HIIACODER/Sol-Mk.-I/BOM.csv

Designator | Footprint | Quantity | Value | LCSC Part #
C1, C10, C14 | C_0402 | 3 | 1uF
C11, C12, C13, C16, C17, C18, C2, C4, C5, C7, C8, C9 | C_0402 | 12 | 10uF
C15, C19, C20, C22, C24, C28, C29, C30, C31, C32, C33, C34, C35, C36, C40, C41, C42 | C_0402 | 17 | 100nF
C21 | C_0402 | 1 | 10nF
C23 | C_0402 | 1 | 2.2uF
C25, C26 | C_0603 | 2 | 4.7uF
C3 | C_0402 | 1 | 47nF
C37, C6 | C_0402 | 2 | 4.7uF
C38, C39 | C_0402 | 2 | 15pF
CARD1 | TF-SMD_TF-01A | 1 | TF-01A | C91145
CN1 | CONN-TH_XT30UPB-M | 1 | XT30UPB-M | C428721
D1 | SOT-23-6_L2.9-W1.6-P0.95-LS2.8-BL | 1 | USBLC6-2SC6 | C7519
D2 | C19273150_LED0603-RD | 1 | LED | C19273150
D4 | C22371297_LED0603-RD_GREEN | 1 | Signal LED1 | C22371297
H5 | C2937625_HDR-TH_3P-P2_54-V-M_PZ254V-11-03P | 1 | SERVOH1 | C2937625
H6 | C2937625_HDR-TH_3P-P2_54-V-M_PZ254V-11-03P | 1 | SERVOH2 | C2937625
H7 | C2937625_HDR-TH_3P-P2_54-V-M_PZ254V-11-03P | 1 | SERVON1 | C2937625
H8 | C2937625_HDR-TH_3P-P2_54-V-M_PZ254V-11-03P | 1 | SERVON2 | C2937625
H9 | C2937625_HDR-TH_3P-P2_54-V-M_PZ254V-11-03P | 1 | DEBUG | C2937625
L1 | C42455356_IND-SMD_APH252012C3R3MP01 | 1 | 1uH | C42455356
L2 | C42411119_IND-SMD_L2_0-W1_6_AOTA-B201610S3R3-101-T | 1 | 3.3uH | C42411119
R1, R2 | R0402 | 2 | 5.1K | C25104
R10, R11, R18, R19, R20, R21, R22, R23, R24, R6, R8, R9, TH1 | R0402 | 13 | 10K | C25104
R12 | R0402 | 1 | 75K | C25104
R13 | R0402 | 1 | 24K | C25104
R14, R15 | R0402 | 2 | 100K | C25104
R16 | R0402 | 1 | 105K | C25104
R17 | R0402 | 1 | 20K | C25104
R25, R26, R7 | R0402 | 3 | 1K | C25104
R27 | R0402 | 1 | 33 | C25104
R28, R29 | R0402 | 2 | 27 | C25104
R3 | R0402 | 1 | 5.23K | C25104
R30 | R0402 | 1 | 130 | C25104
R4 | R0402 | 1 | 30.1K | C25104
R5 | R0402 | 1 | 383 | C25104
SW1 | C720477_SW-SMD_L3_9-W3_0-P4_45 | 1 | SW_Push | C720477
U1 | VFQFPN-24_L4.0-W4.0-P0.50-BL-EP2.8 | 1 | BQ25883RGER | C544362
U2 | C41378174_QFN-60_L7_0-W7_0-P0_40-TL-EP3_4 | 1 | RP2354A | C41378174
U3, U4 | C473914_USIP-8_L3_0-W2_8-P0_65-TL-EP | 2 | TPS82130SILR | C473914
U5 | LGA-10_L2.0-W2.0-P0.50-TL_BMP581 | 1 | BMP581 | C5362283
U6 | C1850418_LGA-14_L3_0-W2_5-P0_50-TL | 1 | ICM-42688-P | C1850418
U7 | C20625731_CRYSTAL-SMD_4P-L3_2-W2_5-BL | 1 | Crystal | C20625731
USB1 | USB-C-SMD_TYPE-C-16PIN-2MD-073 | 1 | TYPE-C 16PIN 2MD | C2765186
