HIIACODER/Sol-Mk.-I/Hardware/PCB/.stl

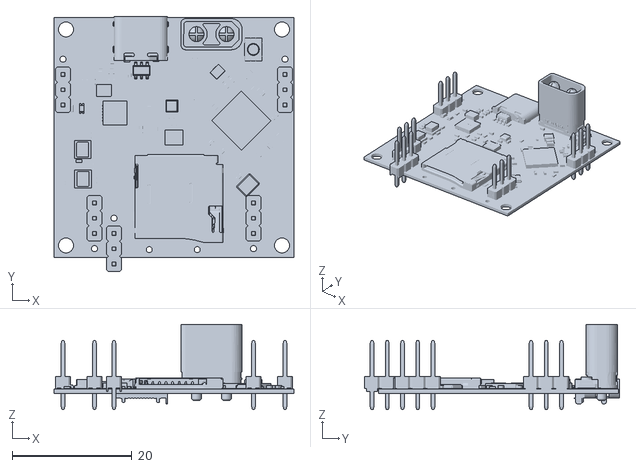
[picture p1: CAD file, 2026-11-11]
Hardware/PCB/.stl
40.0 x 42.5 x 14.2
