HIIACODER/Sol-Mk.-I/Hardware/PCB/PCB.kicad_pcb

## KiCad design Hardware/PCB/PCB.kicad_pcb (2026-11-12)

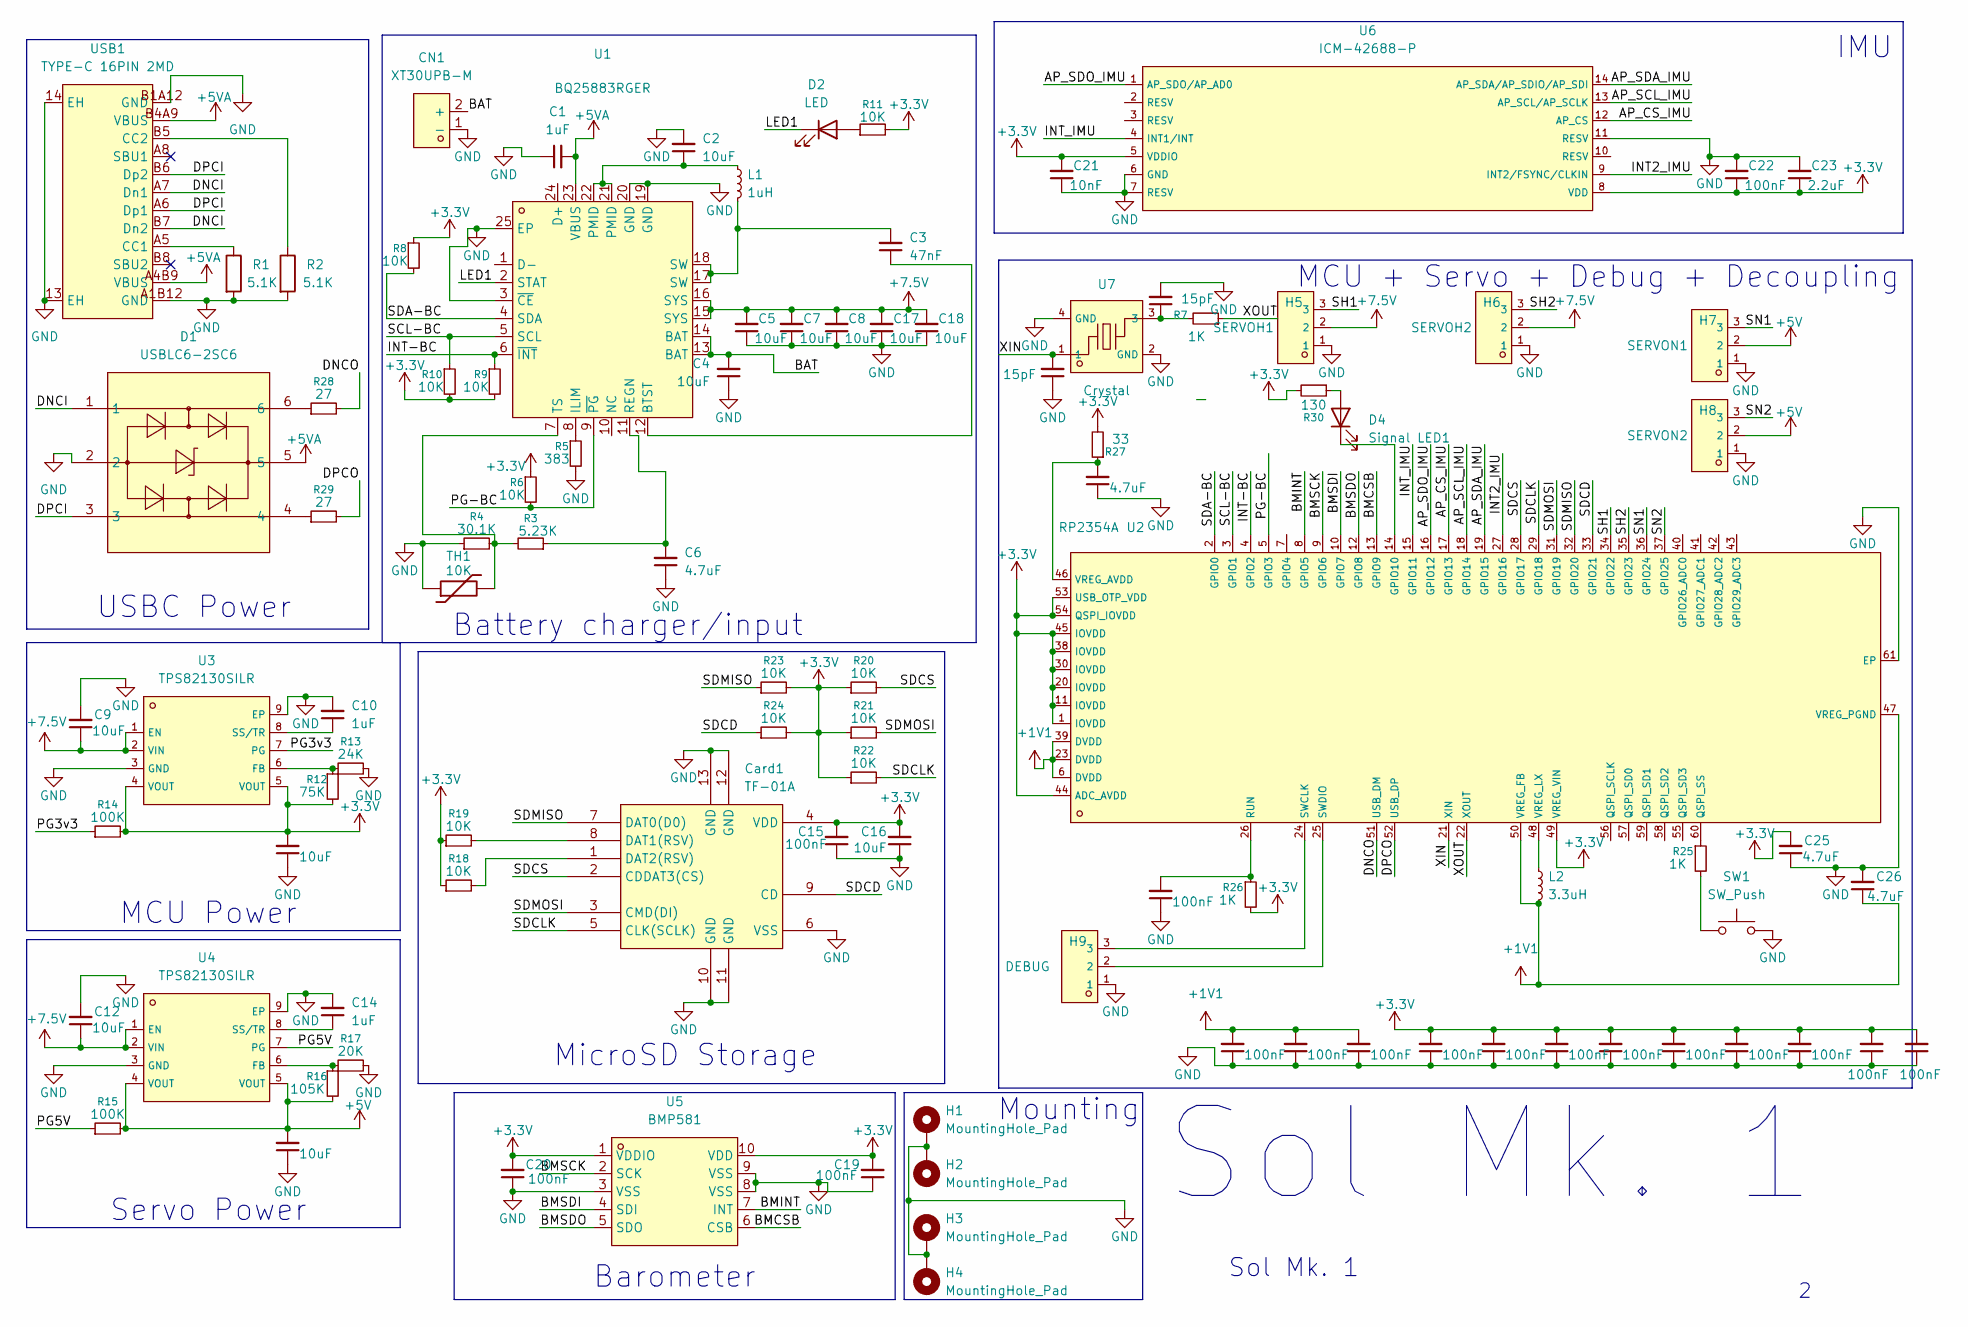
[picture p2: schematic PCB.kicad_sch]

Parts:
C1, C10, C14: 1uF; C_0402
C2, C4, C5, C7, C8, C9, C11, C12, C13, C16, C17, C18: 10uF; C_0402
C3: 47nF; C_0402
C6, C37: 4.7uF; C_0402
C15, C19, C20, C22, C24, C28, C29, C30, C31, C32, C33, C34, C35, C36, C40, C41, C42: 100nF; C_0402
C21: 10nF; C_0402
C23: 2.2uF; C_0402
C25, C26: 4.7uF; C_0603
C38, C39: 15pF; C_0402
CN1: XT30UPB-M; CONN-TH_XT30UPB-M; MPN XT30UPB-M; LCSC Part C428721
Card1: TF-01A; TF-SMD_TF-01A; MPN TF-01A; LCSC Part C91145
D1: USBLC6-2SC6; SOT-23-6_L2.9-W1.6-P0.95-LS2.8-BL; MPN USBLC6-2SC6; LCSC Part C7519
D2: LED; C19273150_LED0603-RD
D4: Signal LED1; C22371297_LED0603-RD_GREEN
H1, H2, H3, H4: MountingHole_Pad; MountingHole_2.5mm
H5: SERVOH1; C2937625_HDR-TH_3P-P2_54-V-M_PZ254V-11-03P; LCSC C2937625
H6: SERVOH2; C2937625_HDR-TH_3P-P2_54-V-M_PZ254V-11-03P; LCSC C2937625
H7: SERVON1; C2937625_HDR-TH_3P-P2_54-V-M_PZ254V-11-03P; LCSC C2937625
H8: SERVON2; C2937625_HDR-TH_3P-P2_54-V-M_PZ254V-11-03P; LCSC C2937625
H9: DEBUG; C2937625_HDR-TH_3P-P2_54-V-M_PZ254V-11-03P; LCSC C2937625
L1: 1uH; C42455356_IND-SMD_APH252012C3R3MP01
L2: 3.3uH; C42411119_IND-SMD_L2_0-W1_6_AOTA-B201610S3R3-101-T
R1, R2: 5.1K; R0402
R3: 5.23K; R0402
R4: 30.1K; R0402
R5: 383; R0402
R6, R8, R9, R10, R11, R18, R19, R20, R21, R22, R23, R24: 10K; R0402
R7, R25, R26: 1K; R0402
R12: 75K; R0402
R13: 24K; R0402
R14, R15: 100K; R0402
R16: 105K; R0402
R17: 20K; R0402
R27: 33; R0402
R28, R29: 27; R0402
R30: 130; R0402
SW1: SW_Push; C720477_SW-SMD_L3_9-W3_0-P4_45
TH1: 10K; R0402
U1: BQ25883RGER; VFQFPN-24_L4.0-W4.0-P0.50-BL-EP2.8; MPN BQ25883RGER; LCSC Part C544362
U2: RP2354A; C41378174_QFN-60_L7_0-W7_0-P0_40-TL-EP3_4; LCSC C41378174
U3, U4: TPS82130SILR; C473914_USIP-8_L3_0-W2_8-P0_65-TL-EP; LCSC C473914
U5: BMP581; LGA-10_L2.0-W2.0-P0.50-TL_BMP581; MPN BMP581; LCSC Part C5362283
U6: ICM-42688-P; C1850418_LGA-14_L3_0-W2_5-P0_50-TL; LCSC C1850418
U7: Crystal; C20625731_CRYSTAL-SMD_4P-L3_2-W2_5-BL; LCSC C20625731
USB1: TYPE-C 16PIN 2MD; USB-C-SMD_TYPE-C-16PIN-2MD-073; MPN TYPE-C 16PIN 2MD(073); LCSC Part C2765186

Connections:
+1V1: C26.1, C28.2, C29.2, C41.2, L2.2, U2.6 (DVDD), U2.23 (DVDD), U2.39 (DVDD), U2.50 (VREG_FB)
+3.3V: C11.2, C15.2, C16.2, C19.2, C20.2, C21.2, C22.1, C23.1, C25.2, C30.2, C31.2, C32.2, C33.2, C34.2, C35.2, C36.2, C40.2, C42.2, Card1.4 (VDD), R6.1, R8.1, R9.2, R10.2, R11.2, R12.2, R14.2, R18.1, R19.1, R20.1, R21.1, R22.1, R23.2, R24.2, R26.2, R27.2, R30.2, U2.1 (IOVDD), U2.11 (IOVDD), U2.20 (IOVDD), U2.30 (IOVDD), U2.38 (IOVDD), U2.44 (ADC_AVDD), U2.45 (IOVDD), U2.49 (VREG_VIN), U2.53 (USB_OTP_VDD), U2.54 (QSPI_IOVDD), U3.4 (VOUT), U3.5 (VOUT), U5.1 (VDDIO), U5.10 (VDD), U6.5 (VDDIO), U6.8 (VDD)
+5V: C13.2, H7.2, H8.2, R15.2, R16.2, U4.4 (VOUT), U4.5 (VOUT)
+5VA: C1.2, D1.5, U1.23 (VBUS), USB1.A4B9 (VBUS), USB1.B4A9 (VBUS)
+7.5V: C5.2, C7.2, C8.2, C9.1, C12.1, C17.2, C18.2, H5.2, H6.2, U1.15 (SYS), U1.16 (SYS), U3.1 (EN), U3.2 (VIN), U4.1 (EN), U4.2 (VIN)
/AP_CS_IMU: U2.17 (GPIO13), U6.12 (AP_CS)
/AP_SCL_IMU: U2.18 (GPIO14), U6.13 (AP_SCL/AP_SCLK)
/AP_SDA_IMU: U2.19 (GPIO15), U6.14 (AP_SDA/AP_SDIO/AP_SDI)
/AP_SDO_IMU: U2.16 (GPIO12), U6.1 (AP_SDO/AP_AD0)
/BAT: C4.2, CN1.2 (+), U1.13 (BAT), U1.14 (BAT)
/BMCSB: U2.13 (GPIO9), U5.6 (CSB)
/BMINT: U2.8 (GPIO5), U5.7 (INT)
/BMSCK: U2.9 (GPIO6), U5.2 (SCK)
/BMSDI: U2.10 (GPIO7), U5.4 (SDI)
/BMSDO: U2.12 (GPIO8), U5.5 (SDO)
/DNCI: D1.1, USB1.A7 (Dn1), USB1.B7 (Dn2)
/DNCO: R28.2, U2.51 (USB_DM)
/DPCI: D1.3, USB1.A6 (Dp1), USB1.B6 (Dp2)
/DPCO: R29.2, U2.52 (USB_DP)
/INT2_IMU: U2.27 (GPIO16), U6.9 (INT2/FSYNC/CLKIN)
/INT-BC: R9.1, U1.6 (~INT), U2.4 (GPIO2)
/INT_IMU: U2.15 (GPIO11), U6.4 (INT1/INT)
/LED1: D2.1 (K), U1.2 (STAT)
/PG3v3: R14.1, U3.7 (PG)
/PG5V: R15.1, U4.7 (PG)
/PG-BC: R6.2, U1.9 (~PG), U2.5 (GPIO3)
/SCL-BC: R10.1, U1.5 (SCL), U2.3 (GPIO1)
/SDA-BC: R8.2, U1.4 (SDA), U2.2 (GPIO0)
/SDCD: Card1.9 (CD), R24.1, U2.33 (GPIO21)
/SDCLK: Card1.5 (CLK(SCLK)), R22.2, U2.29 (GPIO18)
/SDCS: Card1.2 (CDDAT3(CS)), R20.2, U2.28 (GPIO17)
/SDMISO: Card1.7 (DAT0(D0)), R23.1, U2.32 (GPIO20)
/SDMOSI: Card1.3 (CMD(DI)), R21.2, U2.31 (GPIO19)
/SH1: H5.3, U2.34 (GPIO22)
/SH2: H6.3, U2.35 (GPIO23)
/SN1: H7.3, U2.36 (GPIO24)
/SN2: H8.3, U2.37 (GPIO25)
/XIN: C38.2, U2.21 (XIN), U7.1
/XOUT: R7.1, U2.22 (XOUT)
GND: C1.1, C2.2, C4.1, C5.1, C6.1, C7.1, C8.1, C9.2, C10.2, C11.1, C12.2, C13.1, C14.2, C15.1, C16.1, C17.1, C18.1, C19.1, C20.1, C21.1, C22.2, C23.2, C24.1, C25.1, C26.2, C28.1, C29.1, C30.1, C31.1, C32.1, C33.1, C34.1, C35.1, C36.1, C37.1, C38.1, C39.2, C40.1, C41.1, C42.1, CN1.1 (-), Card1.6 (VSS), Card1.10 (GND), Card1.11 (GND), Card1.12 (GND), Card1.13 (GND), D1.2, H1.1, H2.1, H3.1, H4.1, H5.1, H6.1, H7.1, H8.1, H9.1, R1.2, R2.2, R4.1, R5.2, R13.2, R17.2, SW1.2, TH1.1, U1.3 (~CE), U1.19 (GND), U1.20 (GND), U1.25 (EP), U2.47 (VREG_PGND), U2.61 (EP), U3.3 (GND), U3.9 (EP), U4.3 (GND), U4.9 (EP), U5.3 (VSS), U5.8 (VSS), U5.9 (VSS), U6.6 (GND), U6.7 (RESV), U6.11 (RESV), U7.2 (GND), U7.4 (GND), USB1.13 (EH), USB1.14 (EH), USB1.A1B12 (GND), USB1.B1A12 (GND)
unnamed: C2.1, L1.1, U1.21 (PMID), U1.22 (PMID)
unnamed: C3.2, L1.2, U1.17 (SW), U1.18 (SW)
unnamed: C39.1, R7.2, U7.3
unnamed: Card1.8 (DAT1(RSV)), R19.2
unnamed: Card1.1 (DAT2(RSV)), R18.2
unnamed: D1.4, R29.1
unnamed: D1.6, R28.1
unnamed: D2.2 (A), R11.1
unnamed: D4.2 (A), R30.1
unnamed: D4.1 (K), U2.14 (GPIO10)
unnamed: R25.2, SW1.1
unnamed: C3.1, U1.12 (BTST)
unnamed: R5.1, U1.8 (ILIM)
unnamed: C6.2, R3.1, U1.11 (REGN)
unnamed: R3.2, R4.2, TH1.2, U1.7 (TS)
unnamed: R25.1, U2.60 (QSPI_SS)
unnamed: C24.2, R26.1, U2.26 (RUN)
unnamed: H9.3, U2.24 (SWCLK)
unnamed: H9.2, U2.25 (SWDIO)
unnamed: C37.2, R27.1, U2.46 (VREG_AVDD)
unnamed: L2.1, U2.48 (VREG_LX)
unnamed: R12.1, R13.1, U3.6 (FB)
unnamed: C10.1, U3.8 (SS/TR)
unnamed: R16.1, R17.1, U4.6 (FB)
unnamed: C14.1, U4.8 (SS/TR)
unnamed: R1.1, USB1.A5 (CC1)
unnamed: R2.1, USB1.B5 (CC2)

Notes on the sheet:
Mounting
Servo Power
Sol Mk. 1
MCU + Servo + Debug + Decoupling
USBC Power
Barometer
Battery charger/input
IMU
MCU Power
MicroSD Storage

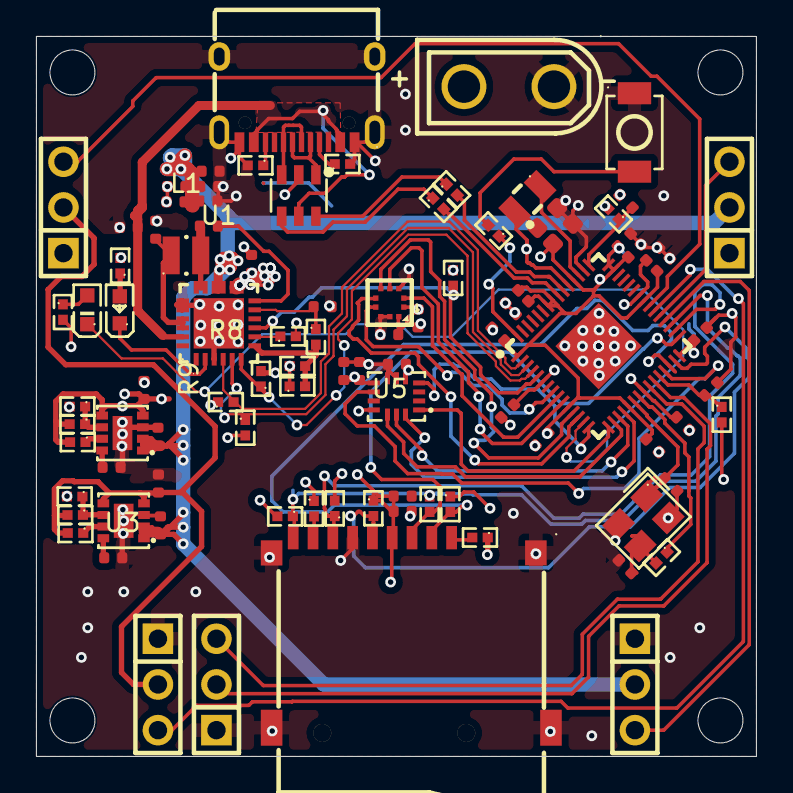
[picture p3: board PCB.kicad_pcb from above]

Board: 6 copper layers, 40.0 x 40.0 mm, 97 parts (0 on the bottom side), 67 nets.
