HIIACODER/Sol-Mk.-I/(commit log)

2026-09-17 finishing up schem
    [PCB.csv, PCB.kicad_pcb, PCB.kicad_sch]
2026-09-20 PCB routing started, added BOM.CSV
    [Flight_Computer_BOM.csv, PCB.csv, PCB.kicad_pcb, PCB.kicad_sch]
2026-09-22 Battery charging added to PCB
    [BOM.csv, PCB.kicad_pcb, PCB.kicad_sch]
2026-09-30 Restarting PCB, finished Flash memory application
    [PCB.kicad_pcb, PCB.kicad_sch]
2026-10-09 Got some advice, restarting entire project, applied integrated inductors to schematic, and restarted it
    [PCB.kicad_pcb, PCB.kicad_sch]
2026-10-09 Power IC complete
    [PCB.kicad_sch]
2026-10-16 Restarted Schematic Finished!
2026-11-11 Full PCB, including silkscreen, finished
2026-11-12 minor PCB edits
2026-11-12 Update README with project details and BOM
    Expanded project description, added PCB details, flashing instructions, BOM, and pricing information.
